carvalhorod09-beep/Alarm-Clock/docs/schematic.png

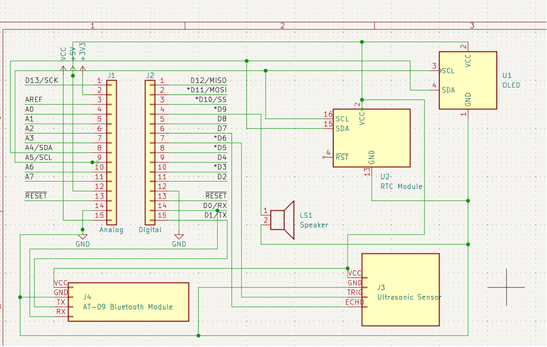
docs/schematic.png
